hooligan1734-collab/PassPuck/case/PassPuck_case_rp2040.3mf

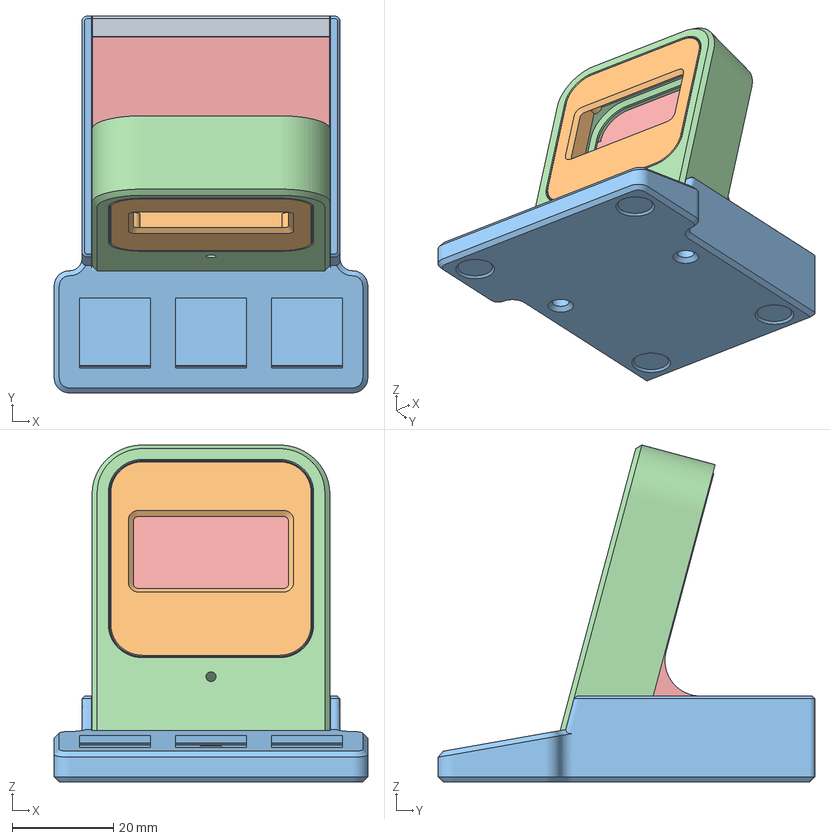
[picture p1: CAD file, 2026-10-15]
case/PassPuck_case_rp2040.3mf
62.0 x 74.5 x 66.6 mm
RP2040-Zero-Holder
бизель 1,3'
корпус кнопок саморезы
корпус экрана вставки
крышка световод
