hooligan1734-collab/PassPuck/docs/PassPuck-manual.pdf

ИНСТРУКЦИЯ ПО СБОРКЕ, ПРОШИВКЕ И РАБОТЕ · PASSPUCK 2.4

# PassPuck

Карманный менеджер паролей. Компьютер видит его как обычную USB-

клавиатуру: выберите профиль кнопками, нажмите «Ввод», и

устройство само наберёт пароль. Ещё PassPuck может не давать

компьютеру уснуть и блокирует его сочетанием кнопок.

6 профилей паролей | пароли на латинице и по-русски | 3 кнопки
экран OLED 1.3″ | плата Waveshare RP2040-Zero | CircuitPython 10.2.1
1. Что понадобится
2. Контакты платы RP2040-Zero
3. Таблица соединений
4. Экран: где какой контакт
5. Кнопки: какие ножки паять
6. Общая схема
7. Пайка и проверка
8. Прошивка
9. Первый запуск
10. Настройка Windows
11. Пароли и названия профилей
12. Управление и меню
13. Пульт для музыки и видео
14. Игра «Змейка»
15. Режим редактирования
16. Тонкая настройка
17. Если что-то не работает
18. Безопасность

## Что понадобится

ДЕТАЛЬ | ЧТО ИМЕННО | КОЛ-ВО
Плата | Waveshare RP2040-Zero (маленькая, с USB-C и RGB-
| светодиодом)

1

Экран | OLED 1.3″ I2C (на обороте надпись «1.30″ IIC», контроллер
| SH1106), 4 контакта. Подойдёт и 0.96″ SSD1306, но тогда
| нужна одна правка в коде (раздел 16)

1

Кнопки | Тактовые кнопки без фиксации, 4 ножки (обычно 6×6 мм) | 3
Провод | Тонкий монтажный (МГТФ 0,07–0,12 мм² или аналог), лучше
| нескольких цветов

~50

см

Корпус | Файл PassGen_full_case_rp2040.3mf из папки 4_корпус
| комплекта

1

Кабель | USB-C с передачей данных (кабели «только для зарядки» не
| подойдут)

1

Инструмент: паяльник (лучше с регулировкой, около 300–330 °C), припой с

флюсом, флюс, кусачки, пинцет, мультиметр. Мультиметр нужен обязательно:

перед первым включением им проверяется, что нет замыкания.

01

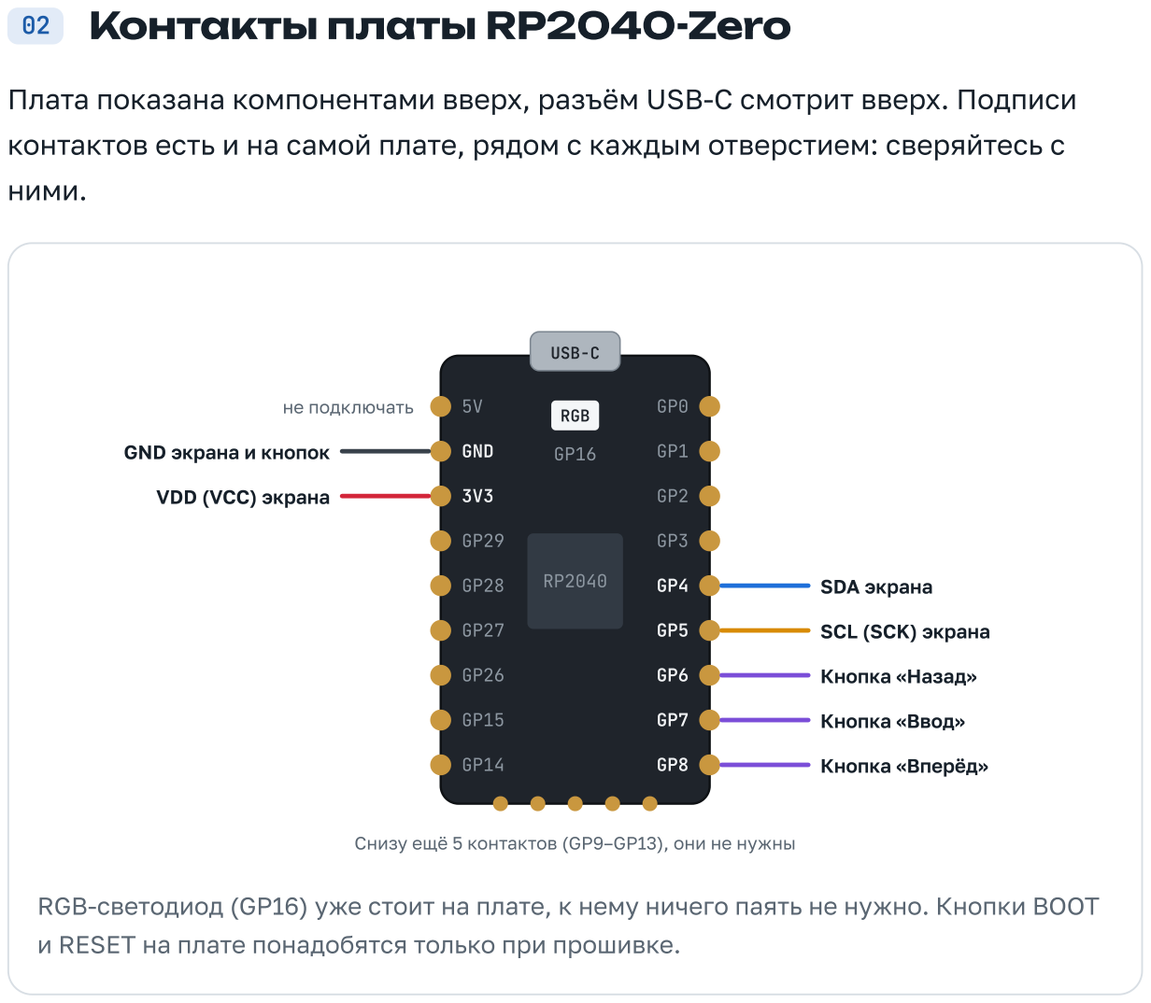
[picture p13: figure]
Контакты платы RP2040⁻Zero; ними.; USB-C; RGB; GND; не подключать; GND экрана и кнопок; VDD (VCC) экрана; SDA экрана; SCL (SCK) экрана; Кнопка «Назад»; Кнопка «Ввод»; Кнопка «Вперёд»

Плата показана компонентами вверх, разъём USB-C смотрит вверх. Подписи

контактов есть и на самой плате, рядом с каждым отверстием: сверяйтесь с

Снизу ещё 5 контактов (GP9–GP13), они не нужны

RGB-светодиод (GP16) уже стоит на плате, к нему ничего паять не нужно. Кнопки BOOT

и RESET на плате понадобятся только при прошивке.

## Таблица соединений

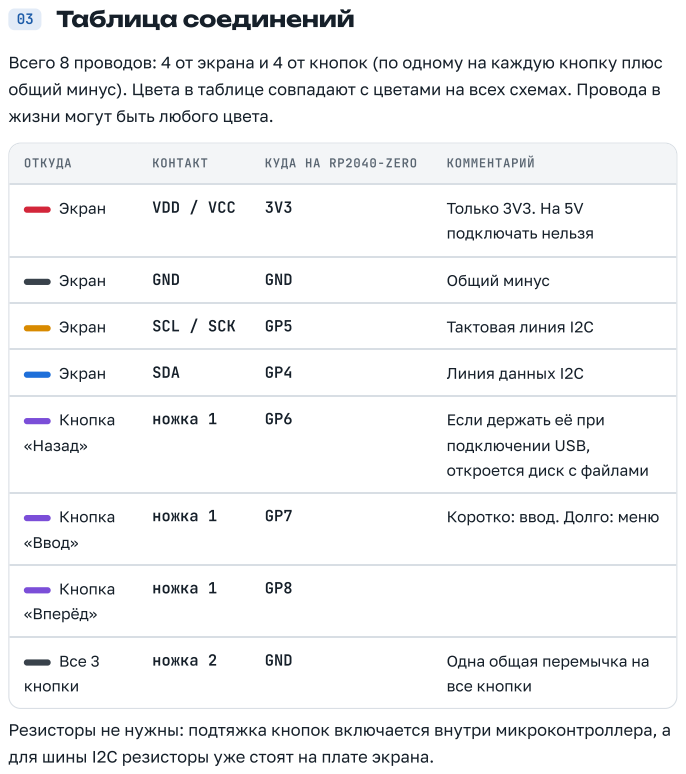
[picture p14: page 4]
ОТКУДА; КОНТАКТ; КУДА НА RP2040-ZERO; КОММЕНТАРИЙ; Экран; VDD / VCC; Только 3V3. На 5V; подключать нельзя; GND; Общий минус; SCL / SCK; Тактовая линия I2C; SDA; Линия данных I2C; Кнопка; «Назад»; ножка 1; Если держать её при; подключении USB,; «Ввод»; Коротко: ввод. Долго: меню; «Вперёд»; Все 3; кнопки; ножка 2; Одна общая перемычка на; все кнопки

Всего 8 проводов: 4 от экрана и 4 от кнопок (по одному на каждую кнопку плюс

общий минус). Цвета в таблице совпадают с цветами на всех схемах. Провода в

жизни могут быть любого цвета.

откроется диск с файлами

Резисторы не нужны: подтяжка кнопок включается внутри микроконтроллера, а

для шины I2C резисторы уже стоят на плате экрана.

## Экран: где какой контакт

У экрана 4 контакта в один ряд. Подписи обычно напечатаны на лицевой

стороне, над стеклом. С обратной стороны подписей нет, и порядок там

зеркальный: пин 1, который спереди крайний слева, сзади оказывается крайним

справа.

VDD | GND | SCL | SDA
1 | 2 | 3 | 4

стекло

3V3 | GND | GP5 | GP4

Спереди: стекло смотрит на вас

SDA | SCL | GND | VDD
4 | 3 | 2 | 1

1.30" IIC

перемычки 1(VDD) · 1(GND)

шлейф стекла

GP4 | GP5 | GND | 3V3

Сзади: так экран лежит в корпусе

Над каждым контактом подписано, куда он идёт на RP2040-Zero. Показан самый

распространённый вариант: пин 1 = VDD, пин 2 = GND.

Перед пайкой проверьте, где у вашего экрана плюс, а где минус

На экранах 1.3″ первые два контакта можно поменять местами перемычками на

обороте. Бывают модули с порядком GND VDD SCL SDA . Если перепутать питание,

экран сгорит. SDA и SCL всегда стоят на 3-м и 4-м местах, их путаница ничего не

сожжёт.

Как узнать порядок, если подписи спереди не видно

На обороте у разъёма есть две строки перемычек: 1(VDD) … 1(GND) и

2(VDD) … 2(GND) . В каждой строке стоит маленький чёрный резистор-

перемычка, и он сдвинут к одной из надписей. Эта надпись и есть назначение

контакта.

04

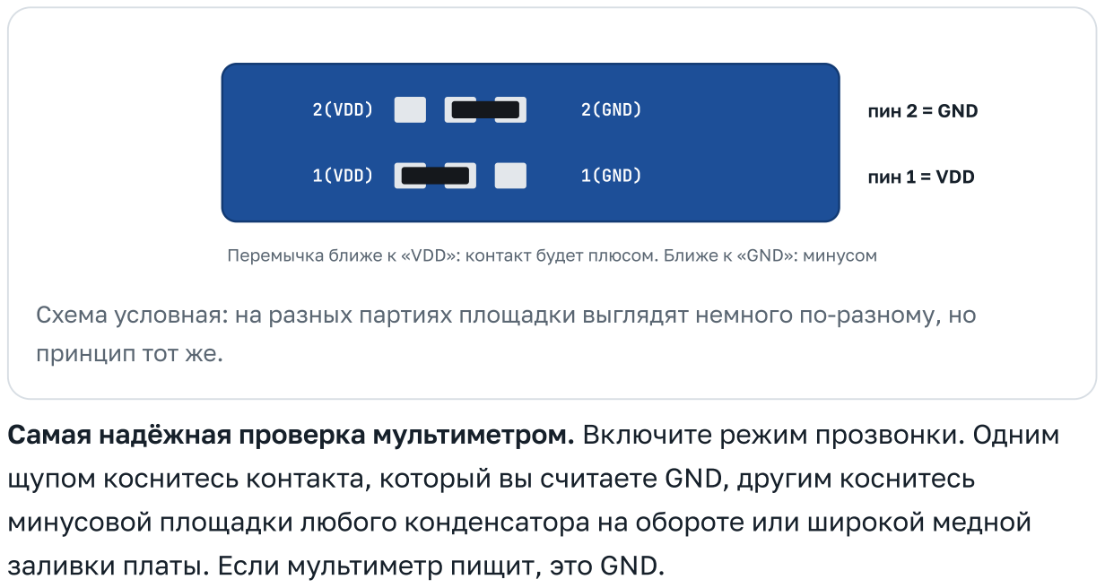
[picture p15: figure]
2(VDD); 2(GND); 1(VDD); 1(GND); пин 2 = GND; пин 1 = VDD; принцип тот же.

Перемычка ближе к «VDD»: контакт будет плюсом. Ближе к «GND»: минусом

Схема условная: на разных партиях площадки выглядят немного по-разному, но

Самая надёжная проверка мультиметром. Включите режим прозвонки. Одним

щупом коснитесь контакта, который вы считаете GND, другим коснитесь

минусовой площадки любого конденсатора на обороте или широкой медной

заливки платы. Если мультиметр пищит, это GND.

## Кнопки: какие ножки паять

У тактовой кнопки 4 ножки, но внутри они попарно соединены. Если припаять

оба провода к ножкам одной пары, кнопка будет «нажата» всегда. Самый

простой способ не ошибиться: паять на ножки по диагонали. Они всегда

относятся к разным парам.

Правильно: по диагонали

к GP

к GND

Работает при любом повороте кнопки

Неправильно: одна пара

к GP | к GND

Ножки уже соединены внутри:

кнопка «нажата» постоянно

Пунктир показывает, какие ножки соединены внутри кнопки всегда

Проверка мультиметром: между выбранными ножками в покое тишина, при нажатии

кнопки писк.

Вторые ножки всех трёх кнопок соедините одной общей перемычкой (голый

луженый провод или отрезок МГТФ от кнопки к кнопке) и одним проводом

заведите на GND платы.

05

## Общая схема

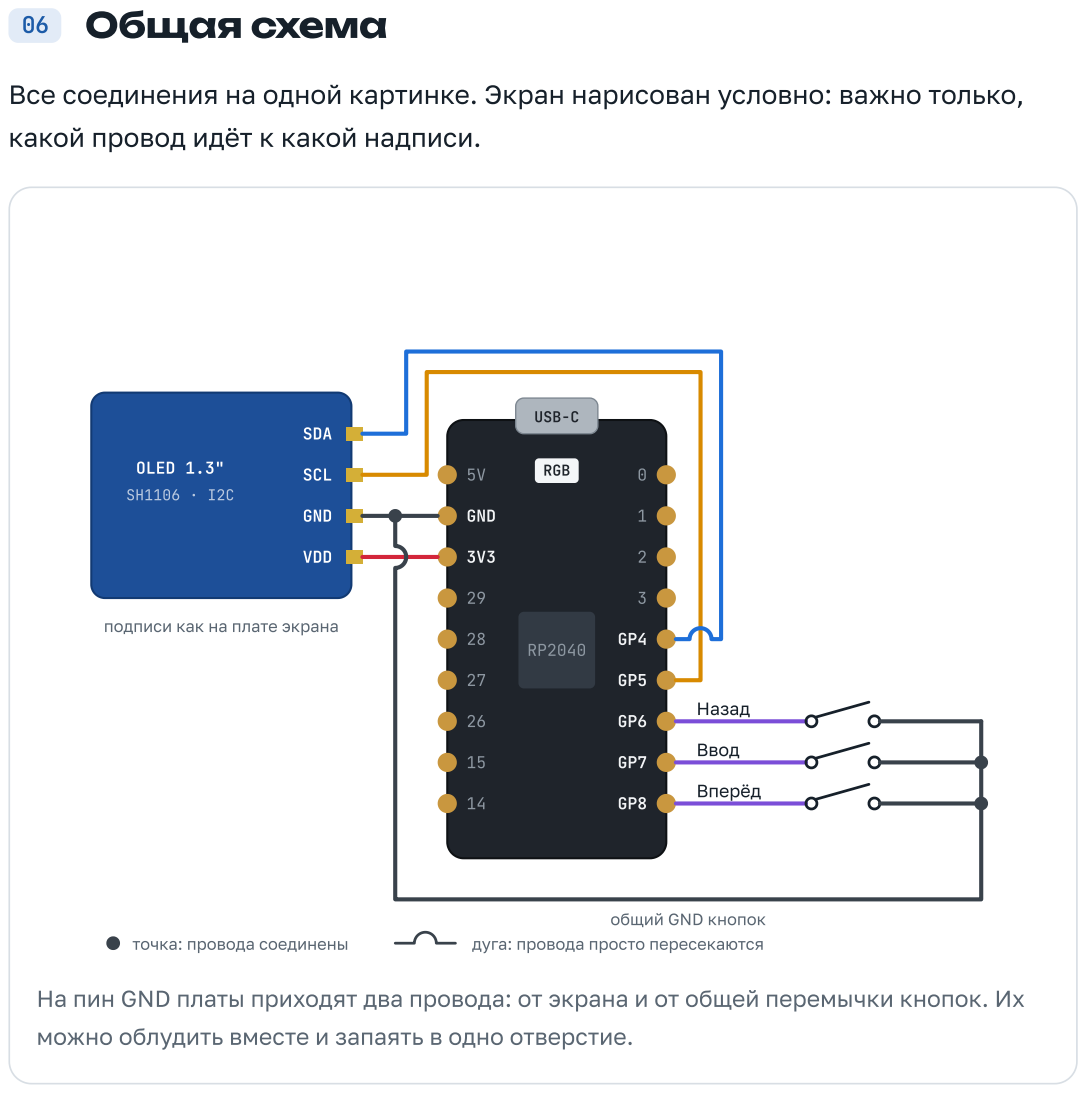
[picture p16: page 8]
OLED 1.3"; SDA; SCL; GND; VDD; USB-C; RGB; Назад; Ввод; Вперёд; точка: провода соединены; дуга: провода просто пересекаются

Все соединения на одной картинке. Экран нарисован условно: важно только,

какой провод идёт к какой надписи.

подписи как на плате экрана

общий GND кнопок

На пин GND платы приходят два провода: от экрана и от общей перемычки кнопок. Их

можно облудить вместе и запаять в одно отверстие.

## Пайка и проверка

Проверка мультиметром до первого подключения к USB

В режиме прозвонки проверьте:

07

Примерьте детали в корпусе. Прикиньте длину проводов с запасом 1–2 см,

чтобы крышка закрывалась без натяга.

1

Залудите все точки пайки: отверстия платы GND, 3V3, GP4–GP8, штырьки

экрана и ножки кнопок. Концы проводов зачистите на 2–3 мм и тоже

залудите.

2

Экран. Определите VDD и GND (раздел 4), затем припаяйте 4 провода

прямо к штырькам. Лишнюю длину штырьков можно откусить, если они

мешают крышке.

3

Кнопки. Сначала соедините вторые ножки всех трёх кнопок общей

перемычкой, потом припаяйте к первым ножкам провода на GP6, GP7, GP8

(раздел 5).

4

Плата. Припаяйте всё к RP2040-Zero по таблице. Паяйте быстро и не

перегревайте плату: 2–3 секунды на точку.

5

Осмотрите пайку. Не должно быть капель припоя между соседними

контактами, особенно между GND и 3V3: они стоят рядом.

6

3V3 и GND платы не звонятся между собой. Если пищит, где-то замыкание,

искать его нужно до включения;

GP4 и GP5 не звонятся с GND и друг с другом;

GP6, GP7, GP8 звонятся с GND только при нажатии своей кнопки.

## Прошивка

Прошивка делается один раз на каждое устройство, и это один файл:

PassPuck-2.4.uf2 из комплекта PassPuck kit.zip (или со страницы Releases на

GitHub). В нём сразу и CircuitPython, и все файлы PassPuck.

шаг 1

Зажать BOOT

Держите кнопку

BOOT на плате и

вставьте USB.

Затем отпустите.

Совсем новая

плата может

открыться и без

кнопки.

шаг 2

Диск RPI-RP2

В «Этом

компьютере»

появится новый

диск, это

загрузчик платы.

шаг 3

Перетащить

.uf2

Перетащите на

него

PassPuck-2.4.uf2

и подождите

около 30 секунд.

шаг 4

Диск CIRCUITPY

Плата

перезагрузится

сама. На экране

«PassPuck

setup», на

компьютере диск

с редактором

паролей.

Дальше — раздел 9.

Только для нового устройства

PassPuck-2.4.uf2 записывает всё заново, и пароли тоже — они станут пустыми.

Работающее устройство обновляйте копированием файлов (ниже).

Что лежит на диске CIRCUITPY

Это для справки и для ручной установки: можно прошить только CircuitPython

( 1_прошивка в комплекте) и скопировать всё из 2_на_устройство в корень

диска. Порядок важен: boot.py всегда последним.

08

CIRCUITPY/

├── lib/ | # библиотеки, папка целиком
├── fonts/ | # шрифт с русскими буквами
├── code.py | # запуск программы (не менять)
├── passpuck.mpy | # сама программа, собранная заранее
├── settings.py | # настройки, можно менять Блокнотом
├── passwords.py | # пароли и названия профилей
├── words.txt | # словарь для паролей из слов
├── PassPuck Editor.html | # редактор паролей

└── boot.py последним

Появятся сами: log.txt | passwords.bak | boot_out.txt
Не нужны: .fseventsd | .Trashes | .Trash-1000 | sd/
.metadata_never_index | settings.toml служебный мусор

Почему boot.py последним

boot.py прячет диск CIRCUITPY при каждом включении. Если скопировать его

раньше остальных файлов и плата перезагрузится, диск пропадёт. Тогда откройте

его кнопкой «Назад» (раздел 15) и докопируйте файлы.

Обновление уже работающего устройства

Откройте диск (раздел 15) и скопируйте всё из 2_на_устройство , кроме

passwords.py и settings.py : в них ваши пароли и настройки. Если на

устройстве лежит hardware_pins.py , не удаляйте его. boot.py — последним.

Версия CircuitPython

Программа passpuck.mpy собрана для CircuitPython 10 — прошивка из комплекта

как раз такая. На CircuitPython 11 и новее она не запустится: светодиод будет

мигать красным «два коротких — пауза». Тогда прошейте плату файлом из

комплекта.

## Первый запуск

Пока в устройстве нет ни одного пароля, оно работает в режиме первой

настройки:

Откройте на диске PassPuck Editor.html , впишите или создайте пароли и

сохраните (раздел 11). Подождите 10 секунд и переподключите устройство.

Теперь оно в обычном режиме:

Хочу создавать пароли прямо на устройстве

Вместо редактора выберите на устройстве SETTINGS → Exit edit mode. Оно

запомнит это, перезапустится в обычном режиме, и пароли профилей 1–3 можно

будет создать через Gen Pass (раздел 12).

09

на секунду появляется заставка PassPuck и номер версии;

затем подсказка

PassPuck setup — Open disk CIRCUITPY — PassPuck Editor.html ;

на компьютере сам появляется диск CIRCUITPY;

внизу главного экрана надпись Open Editor.html .

главный экран: номер профиля 1/6 , крупное название, внизу точки «где я»;

светодиод медленно пульсирует синим;

диск CIRCUITPY не появляется: так задумано, это защита.

## Настройка Windows

Устройство набирает пароль, нажимая клавиши, а какая буква получится,

решает раскладка Windows. Поэтому перед каждым паролем устройство само

переключает раскладку сочетаниями клавиш. Эти сочетания нужно один раз

настроить на каждом компьютере, где используется PassPuck.

Одним щелчком

Дважды щёлкните Настроить Windows.cmd из комплекта (папка 3_windows ) и

отвечайте на вопросы. Скрипт:

проверит, что в Windows есть английский и русский языки (русский

предложит добавить);

назначит Ctrl + Shift + 1 английскому и Ctrl + Shift + 2 русскому;

по желанию скопирует настройки на экран входа в Windows — Windows

спросит разрешение администратора.

Если сочетания не заработали сразу, выйдите из Windows и войдите снова.

Вручную

Чтобы пароль набирался на экране входа в Windows

Экран блокировки работает со своими настройками языка и про сочетания из

шагов выше не знает. Для пароля от Windows скопируйте их туда (нужны права

администратора):

10

Windows 11: Параметры → Время и язык → Ввод → Дополнительные

параметры клавиатуры → Сочетания клавиш для языков ввода.

1

Выберите строку с английским языком → «Сменить сочетание клавиш» →

Ctrl + Shift + 1 .

2

3 | Выберите строку с русским языком → Ctrl + Shift + 2 .
1 | Win + R → intl.cpl → Enter.
2 | Вкладка «Дополнительно» → «Копировать параметры…».

Для профиля с паролем от Windows включите в его меню Ctrl first (раздел 12),

иначе первый символ может потеряться на заставке с часами.

Mac, Linux или чужой компьютер без настройки

Выберите на устройстве SETTINGS → Layout: Off. Тогда PassPuck не трогает

раскладку, и нужный язык вы включаете сами перед нажатием «Ввод». Пароль с

русскими и латинскими буквами вперемешку в этом режиме набрать не

получится.

Отметьте «Экран приветствия и системные учётные записи» → ОК,

перезагрузите компьютер.

3

## Пароли и названия профилей

Профили 1–3 «автоматические»: пароль для них можно сгенерировать прямо на

устройстве. Профили 4–6 «фиксированные»: пароль задаётся только в файле.

Названия профилей на экране можно писать по-русски.

Способ 1. Редактор (удобнее и надёжнее)

Редактор лежит прямо на устройстве, ничего устанавливать не нужно. Работает

в Microsoft Edge или Google Chrome, без интернета.

Редактор сам подсвечивает символы, которые устройство не сможет набрать, и

не даёт сохранить такой файл. Перед сохранением прежняя версия файла

копируется в passwords.bak .

Пароли из слов

Случайный пароль вроде k#8Fq2!xZ… надёжен, но запомнить его почти

невозможно. Пароль из слов устройство тоже выбирает случайно, но из простых

слов в 3–4 буквы: два слова, две цифры и символ.

11

1 | Откройте диск устройства: SETTINGS → Edit mode → «Ввод» (раздел 15).
2 | На диске CIRCUITPY дважды кликните PassPuck Editor.html .
| Нажмите «Открыть устройство», выберите сам диск CIRCUITPY и
| разрешите браузеру изменять файлы.

3

Поменяйте названия и пароли. Кнопка «Создать» генерирует пароль: EN

(буквы, цифры, символы) или RU (русские буквы и цифры) нужной длины,

«Слова» или «Слова RU» — запоминаемый пароль из двух слов (ниже).

Глазик показывает пароль, а у пароля из слов — ещё и подсказку, как его

запомнить.

4

«Сохранить на устройство» → дождитесь зелёного «Сохранено и

проверено» → подождите 10 секунд → на устройстве SETTINGS → Exit edit

mode.

5

ВИД | ВЫ ПОМНИТЕ | ВВОДИТСЯ | ЗАЧЕМ
Words | Кот Луна

47!

RjnKeyf47! | Русские слова, набранные в английской

раскладке. Только латиница — подходит

любому сайту. Вручную печатаете

«котлуна», не переключая раскладку

Words

RU

Кот Луна

47!

КотЛуна47! | Те же слова русскими буквами. Символ в
| конце ( ! % * + - = ) стоит на той же
| клавише в обеих раскладках, поэтому
| весь пароль набирается на русской

Слова берутся из файла words.txt на устройстве (467 слов). Его можно открыть

Блокнотом: удалить слова, которые не нравятся, или добавить свои — по одному

на строке, 3–4 буквы, без букв ж х ъ э б ю ё. «Show Pass» у пароля Words

показывает под ним русскую подсказку.

Насколько это надёжно

Вариантов такого пароля — около 130–175 миллионов. Для входа в Windows этого

с запасом: после 10 неверных попыток Windows блокирует вход. Для почты,

банка и важных сайтов лучше обычный случайный пароль EN.

Способ 2. Вручную в Блокноте

PROFILE_NAMES = {

1: "Рабочая почта",

2: "Ноутбук",

}

AUTO_PASSWORDS = {

1: "пароль профиля 1",

2: "пароль профиля 2",

3: "пароль профиля 3",
}

MANUAL_PASSWORDS = {

4: "пароль профиля 4",

5: "пароль профиля 5",

6: "пароль профиля 6",
}

Меняйте только текст внутри кавычек. Кавычки, двоеточия и запятые не

трогайте.

Можно: латиница, цифры, символы английской клавиатуры, русские буквы

(включая ё и №). Перед " и \ ставьте обратный слэш: \" и \\ .

Названия профилей: до 20 символов, иначе обрежутся на экране.

После сохранения подождите 10 секунд, прежде чем отключать устройство.

Если выдернуть его сразу, файл может испортиться.

Если файл всё-таки испортился

При включении устройство попробует резервную копию passwords.bak и

покажет на экране Backup loaded . Если не читается ни один файл, будет

passwords.py ERROR . Тогда откройте диск и запишите пароли заново

редактором.

## Управление и меню

Главный экран листается по кругу: профили 1–6 → (MEDIA) → (GAME) → JIGGLE →

SETTINGS → профиль 1. Экраны MEDIA и GAME появляются, только если

включить их в SETTINGS (пульт, игра). После включения устройство открывает

профиль, которым вы пользовались последним.

Главный экран профиля

слева вверху — номер профиля, например 2/6 ;

справа вверху — значки: ENT (после пароля нажимается Enter), CTL (Ctrl

first) — видны, только когда включены, и вид генерации EN / RU / Words /

Words RU (профили 1–3);

в центре — название профиля, крупно, если оно не длиннее 10 символов;

внизу — точки «где я»: кружки — профили, квадраты — MEDIA и GAME (если

включены), JIGGLE и SETTINGS. Если у профиля нет пароля, вместо точек

написано No password! .

ДЕЙСТВИЕ | НА ГЛАВНОМ ЭКРАНЕ | В МЕНЮ

«Вперёд» /

«Назад»

Следующий / предыдущий экран | Следующий /
| предыдущий пункт

«Вперёд» /

«Назад» держать

Листать само, пока кнопку не отпустите (примерно 4 шага в

секунду)

«Ввод» коротко | Набрать пароль профиля. На JIGGLE —
| вкл/выкл. На SETTINGS — открыть
| меню

Выбрать пункт

«Ввод» держать

1 с

Открыть меню профиля, JIGGLE или

SETTINGS

Выйти из меню

«Назад» +

«Вперёд»

держать 1 с

Заблокировать компьютер ( Win + L )

«Вперёд» и «Назад» срабатывают в момент отпускания кнопки. Поэтому при

блокировке Win+L профиль на экране не сдвигается — нажимайте обе кнопки

12

почти одновременно.

Меню показывает 4 пункта списком: выбранный выделен белой полосой,

значения настроек — справа, вверху — номер пункта, сбоку — полоска

прокрутки. Каждое меню открывается на том пункте, где вы его закрыли. Выйти

можно пунктом Exit или долгим «Вводом» с любого пункта.

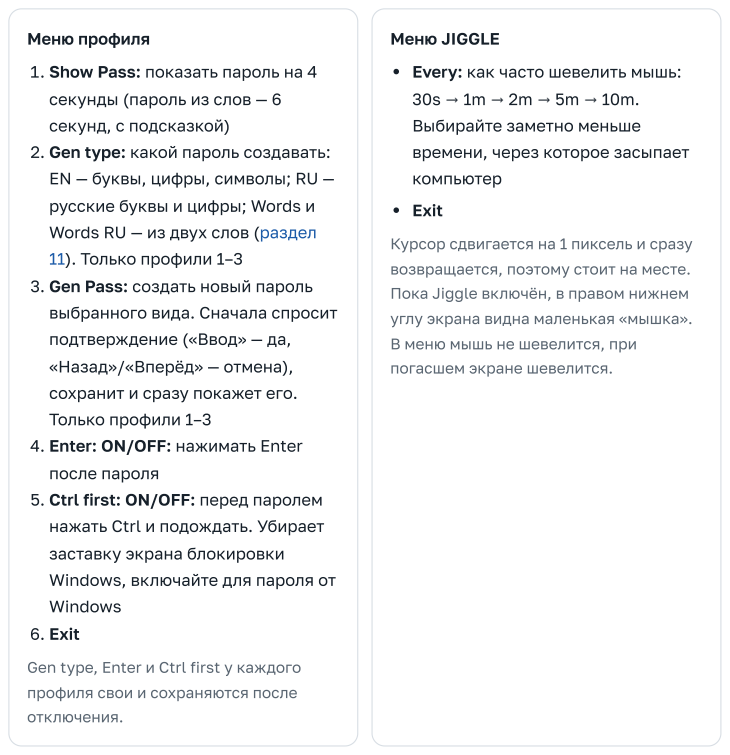
[picture p17: page 20]
Меню профиля; секунд, с подсказкой); 11). Только профили 1–3; Только профили 1–3; после пароля; Windows; 6. Exit; отключения.; Меню JIGGLE; компьютер; Exit

1. Show Pass: показать пароль на 4

Every: как часто шевелить мышь:

секунды (пароль из слов — 6

Выбирайте заметно меньше

2. Gen type: какой пароль создавать:

времени, через которое засыпает

EN — буквы, цифры, символы; RU —

русские буквы и цифры; Words и

Words RU — из двух слов (раздел

Курсор сдвигается на 1 пиксель и сразу

возвращается, поэтому стоит на месте.

3. Gen Pass: создать новый пароль

Пока Jiggle включён, в правом нижнем

выбранного вида. Сначала спросит

углу экрана видна маленькая «мышка».

подтверждение («Ввод» — да,

В меню мышь не шевелится, при

«Назад»/«Вперёд» — отмена),

погасшем экране шевелится.

сохранит и сразу покажет его.

4. Enter: ON/OFF: нажимать Enter

5. Ctrl first: ON/OFF: перед паролем

нажать Ctrl и подождать. Убирает

заставку экрана блокировки

Windows, включайте для пароля от

Gen type, Enter и Ctrl first у каждого

профиля свои и сохраняются после

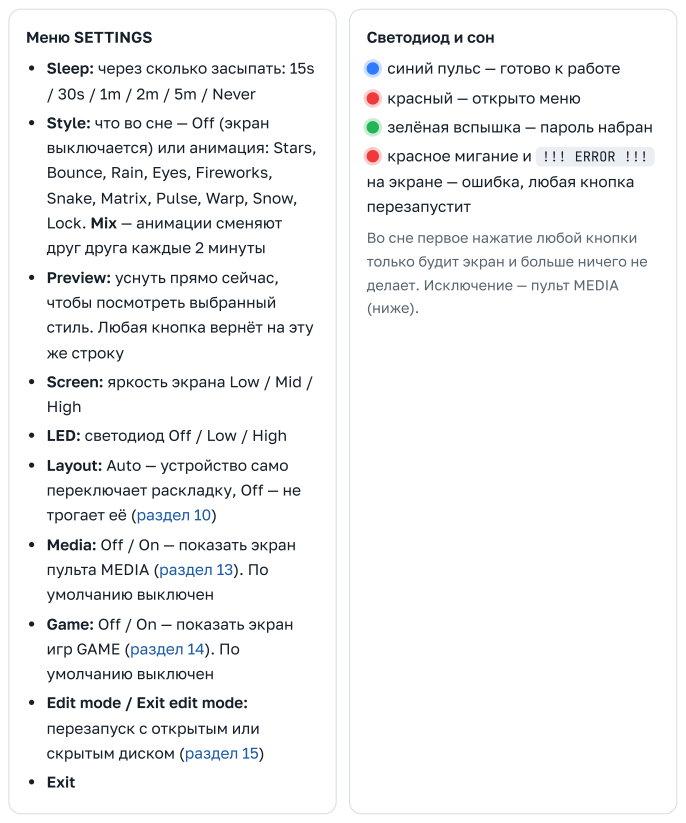
[picture p18: page 21]
Меню SETTINGS; / 30s / 1m / 2m / 5m / Never; же строку; High; умолчанию выключен; Exit; Светодиод и сон; перезапустит; (ниже).

Sleep: через сколько засыпать: 15s

синий пульс — готово к работе

красный — открыто меню

Style: что во сне — Off (экран

зелёная вспышка — пароль набран

выключается) или анимация: Stars,

красное мигание и !!! ERROR !!!

Bounce, Rain, Eyes, Fireworks,

на экране — ошибка, любая кнопка

Snake, Matrix, Pulse, Warp, Snow,

Lock. Mix — анимации сменяют

Во сне первое нажатие любой кнопки

друг друга каждые 2 минуты

только будит экран и больше ничего не

Preview: уснуть прямо сейчас,

делает. Исключение — пульт MEDIA

чтобы посмотреть выбранный

стиль. Любая кнопка вернёт на эту

Screen: яркость экрана Low / Mid /

LED: светодиод Off / Low / High

Layout: Auto — устройство само

переключает раскладку, Off — не

трогает её (раздел 10)

Media: Off / On — показать экран

пульта MEDIA (раздел 13). По

Game: Off / On — показать экран

игр GAME (раздел 14). По

Edit mode / Exit edit mode:

перезапуск с открытым или

скрытым диском (раздел 15)

## Пульт для музыки и видео

PassPuck умеет управлять музыкой и видео на компьютере: пауза, треки,

громкость. Работает в любом плеере, YouTube, Spotify — программы на

компьютере не нужны. Пульт нужен не всем, поэтому по умолчанию он

выключен.

КНОПКА В РЕЖИМЕ ПУЛЬТА | ЧТО ДЕЛАЕТ
«Ввод» | Пауза / воспроизведение
«Вперёд» / «Назад» | Следующий / предыдущий трек
«Вперёд» / «Назад» держать | Громче / тише, пока держите
«Ввод» держать 1 с | Выйти из режима пульта
«Назад» + «Вперёд» держать 1 с | Заблокировать компьютер, как везде

Внизу экрана на секунду видно, что нажато: Next > , Volume + и т.п.

Сон пульту не мешает

Экран гаснет как обычно, но устройство остаётся в режиме пульта. Нажатие на

погасшем экране сразу выполняет действие — например, ставит паузу, без

лишнего «разбудить». С паролями так не бывает: там первое нажатие только

будит экран.

После переподключения устройство открывается на последнем профиле, а пульт

включается заново одним нажатием на экране MEDIA. Убрать пульт совсем:

SETTINGS → Media: Off.

13

Включите: SETTINGS → Media: On. В карусели после профиля 6 появится

экран MEDIA, внизу — ещё одна точка.

1

Долистайте до MEDIA и нажмите «Ввод» — включится режим пульта, на

экране значки ⏮ ⏯ ⏭.

2

## Игра «Змейка»

Чтобы скоротать минутку, на PassPuck есть змейка. Как и пульт, она по

умолчанию выключена.

КНОПКА В ИГРЕ | ЧТО ДЕЛАЕТ
«Назад» | Повернуть налево — относительно того, куда
| ползёт змейка
«Вперёд» | Повернуть направо
«Ввод» | Пауза / продолжить
«Ввод» держать 1 с | Выйти из игры

«Назад» + «Вперёд»

держать 1 с

Заблокировать компьютер (игра встанет на паузу)

Walls: Solid — поле обведено сплошной рамкой, врезаться в неё нельзя. Walls:

Wrap — рамка пунктиром: вышли за край — появились с другой стороны.

Каждая съеденная точка — +1 к счёту, змейка растёт и чуть ускоряется. Счёт и

рекорд — вверху экрана.

После проигрыша: «Ввод» — сыграть ещё, держать «Ввод» — выйти. Рекорд

сохраняется и после отключения.

Пока идёт игра, экран не засыпает, пароли не вводятся, Jiggle продолжает

работать.

14

Включите: SETTINGS → Game: On. В карусели появится экран GAME (между

MEDIA и JIGGLE).

1

2 На экране GAME нажмите «Ввод» → Snake (справа — ваш рекорд).

Выберите Speed (Easy / Normal / Hard) и Walls, затем Start. Выбор

запоминается.

3

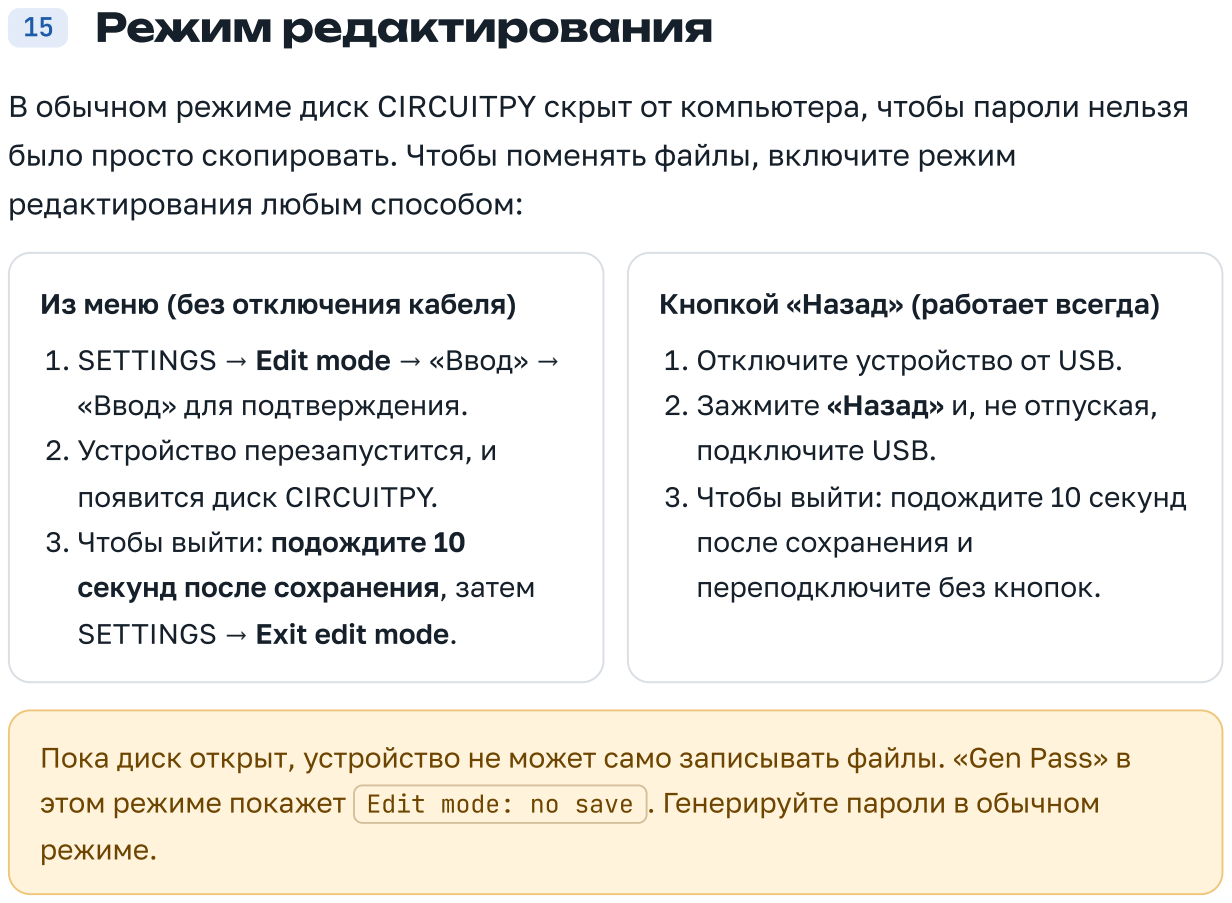
[picture p19: figure]
Режим редактирования; редактирования любым способом:; Из меню (без отключения кабеля); 1. SETTINGS → Edit mode → «Ввод» →; «Ввод» для подтверждения.; 2. Устройство перезапустится, и; появится диск CIRCUITPY.; 3. Чтобы выйти: подождите 10; секунд после сохранения, затем; SETTINGS → Exit edit mode.; Кнопкой «Назад» (работает всегда); 1. Отключите устройство от USB.; 2. Зажмите «Назад» и, не отпуская,; подключите USB.; 3. Чтобы выйти: подождите 10 секунд; после сохранения и; переподключите без кнопок.; режиме.

В обычном режиме диск CIRCUITPY скрыт от компьютера, чтобы пароли нельзя

было просто скопировать. Чтобы поменять файлы, включите режим

Пока диск открыт, устройство не может само записывать файлы. «Gen Pass» в

этом режиме покажет Edit mode: no save . Генерируйте пароли в обычном

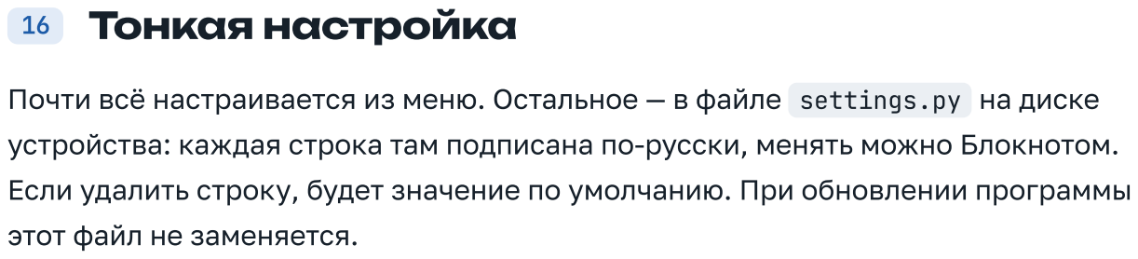
[picture p20: figure]
Тонкая настройка; этот файл не заменяется.

Почти всё настраивается из меню. Остальное — в файле settings.py на диске

устройства: каждая строка там подписана по-русски, менять можно Блокнотом.

Если удалить строку, будет значение по умолчанию. При обновлении программы

НАСТРОЙКА | ЧТО МЕНЯЕТ
OLED_TYPE | "SH1106" для экрана 1.3″, "SSD1306" для

0.96″

PASSWORD_LENGTH , CHARS | Длина и символы пароля EN для Gen Pass

WORDS_SYMBOLS ,

WORDS_RU_SYMBOLS

Из каких символов выбирается последний

символ пароля Words и Words RU (сами

слова — в words.txt )

NAV_REPEAT_DELAY ,

NAV_REPEAT_INTERVAL

Через сколько секунд удержания

«Вперёд»/«Назад» листают сами и с какой

скоростью

MEDIA_VOLUME_INTERVAL | Пульт MEDIA: как быстро меняется
| громкость, пока держите «Вперёд»/«Назад»

TYPING_DELAY ,

TYPING_START_DELAY

Пауза между символами и пауза после Ctrl

first

LANG_EN_HOTKEY ,

LANG_RU_HOTKEY ,

LANG_SWITCH_DELAY

Сочетания переключения раскладки и пауза

после него

SLEEP_PRESETS , JIGGLE_PRESETS | Варианты времени сна и интервалов Jiggle в
| меню

MIX_PERIOD ,

ANIMATION_FRAME_TIME

Сколько секунд показывать каждую

анимацию в Mix и скорость анимаций

SPLASH_TIME | Сколько секунд показывать заставку, 0 — не
| показывать
I2C_FREQUENCY | Скорость связи с экраном. Если на экране
помехи — | 100000

Если кнопки припаяны не к тем контактам

Перепаивать не обязательно. Положите на устройство рядом с settings.py

файл hardware_pins.py только с теми кнопками, которые нужно поменять.

Например, если перепутаны «Ввод» и «Вперёд»:

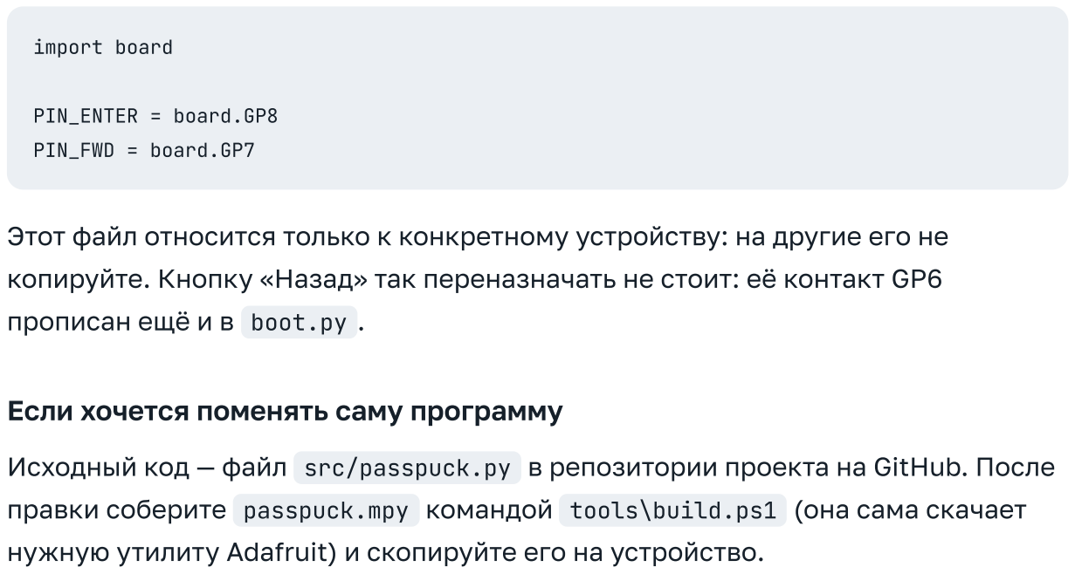
[picture p21: figure]
import board; PIN_ENTER = board.GP8; PIN_FWD = board.GP7; прописан ещё и в boot.py .; Если хочется поменять саму программу

Этот файл относится только к конкретному устройству: на другие его не

копируйте. Кнопку «Назад» так переназначать не стоит: её контакт GP6

Исходный код — файл src/passpuck.py в репозитории проекта на GitHub. После

правки соберите passpuck.mpy командой tools\build.ps1 (она сама скачает

нужную утилиту Adafruit) и скопируйте его на устройство.

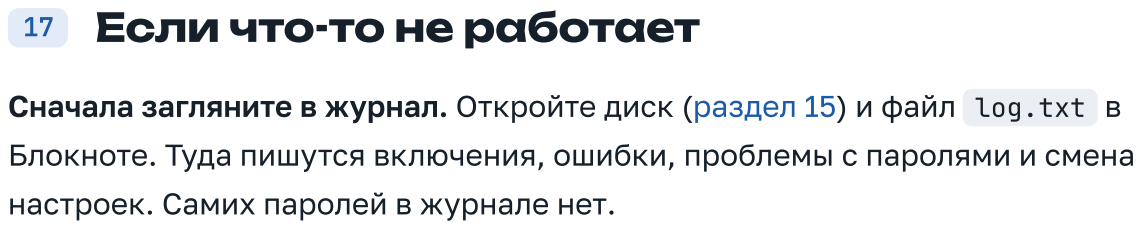
[picture p22: figure]
Если что⁻то не работает; настроек. Самих паролей в журнале нет.

Сначала загляните в журнал. Откройте диск (раздел 15) и файл log.txt в

Блокноте. Туда пишутся включения, ошибки, проблемы с паролями и смена

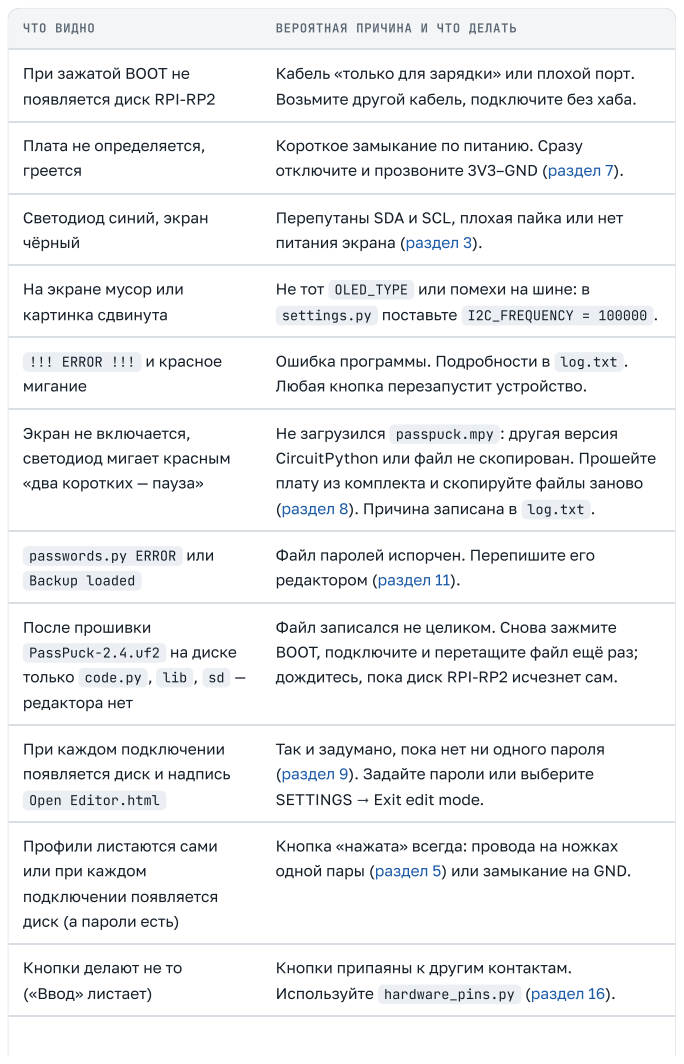
[picture p23: page 29]
ЧТО ВИДНО; ВЕРОЯТНАЯ ПРИЧИНА И ЧТО ДЕЛАТЬ; греется; чёрный; картинка сдвинута; !!! ERROR !!! и красное; мигание; Backup loaded; редактором (раздел 11).; После прошивки; редактора нет; подключении появляется; («Ввод» листает)

При зажатой BOOT не

Кабель «только для зарядки» или плохой порт.

появляется диск RPI-RP2

Возьмите другой кабель, подключите без хаба.

Плата не определяется,

Короткое замыкание по питанию. Сразу

отключите и прозвоните 3V3–GND (раздел 7).

Светодиод синий, экран

Перепутаны SDA и SCL, плохая пайка или нет

питания экрана (раздел 3).

На экране мусор или

Не тот OLED_TYPE или помехи на шине: в

settings.py поставьте I2C_FREQUENCY = 100000 .

Ошибка программы. Подробности в log.txt .

Любая кнопка перезапустит устройство.

Экран не включается,

Не загрузился passpuck.mpy : другая версия

светодиод мигает красным

CircuitPython или файл не скопирован. Прошейте

«два коротких — пауза»

плату из комплекта и скопируйте файлы заново

(раздел 8). Причина записана в log.txt .

passwords.py ERROR или

Файл паролей испорчен. Перепишите его

Файл записался не целиком. Снова зажмите

PassPuck-2.4.uf2 на диске

BOOT, подключите и перетащите файл ещё раз;

только code.py , lib , sd —

дождитесь, пока диск RPI-RP2 исчезнет сам.

При каждом подключении

Так и задумано, пока нет ни одного пароля

появляется диск и надпись

(раздел 9). Задайте пароли или выберите
SETTINGS → Exit edit mode.

Open Editor.html

Профили листаются сами

Кнопка «нажата» всегда: провода на ножках

или при каждом

одной пары (раздел 5) или замыкание на GND.

диск (а пароли есть)

Кнопки делают не то

Кнопки припаяны к другим контактам.

Используйте hardware_pins.py (раздел 16).

ЧТО ВИДНО | ВЕРОЯТНАЯ ПРИЧИНА И ЧТО ДЕЛАТЬ
Печатаются не те символы | Не настроены Ctrl + Shift + 1/2 в Windows
| (раздел 10), либо это Mac/Linux — выберите
| Layout: Off.
Bad chars in P… | В пароле символ, который нельзя набрать (не
| латиница и не русская буква). Исправьте в
| редакторе.

На экране блокировки не

хватает первого символа

Включите в меню профиля Ctrl first.

Русский пароль не проходит

на экране входа

Скопируйте языковые настройки на экран

приветствия: Настроить Windows.cmd или

intl.cpl (раздел 10).

Gen Pass в режиме Words

пишет No words.txt

На устройстве нет словаря или в нём меньше 100

слов. Скопируйте words.txt из комплекта.

Gen Pass пишет

Edit mode: no save

Устройство в режиме редактирования. Выйдите

из него и повторите.

Нет экрана MEDIA | Пульт выключен по умолчанию: SETTINGS →
| Media: On (раздел 13).
Нет экрана GAME | Игры выключены по умолчанию: SETTINGS →
| Game: On (раздел 14).

Пульт MEDIA не управляет

плеером

Проверьте громкость: если она меняется, пульт

работает, а плеер не понимает мультимедийные

клавиши. Браузер (YouTube), Spotify, VLC и

встроенные плееры Windows их понимают.

Компьютер всё равно

засыпает при включённом

Jiggle

Интервал Every больше или равен времени сна

компьютера. Выберите меньше.

Если программа на устройстве испортилась целиком, прошейте его заново

файлом PassPuck-2.4.uf2 (раздел 8). Пароли при этом станут пустыми — если

диск ещё открывается, сначала скопируйте себе passwords.py .

## Безопасность

Пароли хранятся во флеш-памяти открытым текстом: в passwords.py и в

предыдущей версии passwords.bak . Любой, кто знает про режим

редактирования, может их прочитать. Обращайтесь с устройством как с

ключами от квартиры.

«Show Pass» показывает пароль на экране. Не открывайте его при

посторонних.

Устройство набирает пароль туда, где стоит курсор. Перед «Вводом»

убедитесь, что курсор в поле пароля, а не в чате.

Журнал log.txt паролей не содержит. Редактор работает без интернета и

никуда ничего не отправляет.

Быстро заблокировать компьютер: «Назад» + «Вперёд» на 1 секунду.

PassPuck 2.4 · Waveshare RP2040-Zero · CircuitPython 10.2.1 · OLED SH1106 1.3″ I2C, адрес 0x3C ·

шрифт Terminus (SIL OFL 1.1)

18
