hooligan1734-collab/PassPuck/device/settings.py

# =====================================================================
#  PassPuck — НАСТРОЙКИ
#  Меняйте значения справа от «=». Если удалить строку, будет значение
#  по умолчанию. После сохранения подождите 10 секунд, прежде чем отключать
#  устройство. При обновлении программы этот файл не заменяется.
#
#  Пароли и названия профилей — не здесь, а в passwords.py
#  (удобнее через PassPuck Editor.html).
# =====================================================================

import board
from adafruit_hid.keycode import Keycode

# Тип экрана: "SH1106" — экран 1.3", "SSD1306" — экран 0.96"
OLED_TYPE = "SH1106"

# ---------- Генератор паролей (Gen Pass, профили 1-3) ----------
# Вид пароля выбирается для каждого профиля в его меню (пункт «Gen»):
#   EN    — случайные символы из CHARS, длина PASSWORD_LENGTH;
#   RU    — случайные русские буквы и цифры, длина PASSWORD_LENGTH;
#   Words — запоминаемый: два слова из words.txt в английской раскладке + 2 цифры
#           и символ из WORDS_SYMBOLS. Например, «Кот Луна 47!» вводится как RjnKeyf47!
PASSWORD_LENGTH = 12
CHARS = "abcdefghijklmnopqrstuvwxyzABCDEFGHIJKLMNOPQRSTUVWXYZ0123456789!@#$%^&*()_+-="
WORDS_SYMBOLS = "!#$%&*?@"

# ---------- Набор пароля ----------
TYPING_DELAY = 0.05        # пауза между символами, сек
TYPING_START_DELAY = 0.4   # пауза после «Ctrl first» (экран блокировки Windows успевает проснуться)

# Переключение раскладки (для паролей с русскими буквами и при Layout: Auto).
# Эти сочетания нужно один раз назначить в Windows:
#   Параметры → Время и язык → Ввод → Дополнительные параметры клавиатуры →
#   Сочетания клавиш для языков ввода: английский — Ctrl+Shift+1, русский — Ctrl+Shift+2
LANG_EN_HOTKEY = (Keycode.LEFT_CONTROL, Keycode.SHIFT, Keycode.ONE)
LANG_RU_HOTKEY = (Keycode.LEFT_CONTROL, Keycode.SHIFT, Keycode.TWO)
LANG_SWITCH_DELAY = 0.3    # пауза после переключения раскладки, сек

# ---------- Кнопки ----------
LONG_PRESS_TIME = 1.0      # сколько держать «Ввод», чтобы открыть меню, сек
NAV_LOCK_HOLD_TIME = 1.0   # сколько держать «Назад»+«Вперёд» для Win+L, сек
NAV_REPEAT_DELAY = 0.5     # держите «Назад» или «Вперёд» дольше — листает само, сек
NAV_REPEAT_INTERVAL = 0.25 # пауза между шагами при таком листании, сек
MEDIA_VOLUME_INTERVAL = 0.1 # пульт MEDIA (SETTINGS -> Media: On): шаг громкости при удержании, сек
BUTTON_DEBOUNCE = 0.03     # защита от дребезга, сек

# ---------- Сон экрана (выбирается в SETTINGS → Sleep / Style) ----------
SLEEP_PRESETS = (15, 30, 60, 120, 300, 0)   # варианты времени, сек. 0 = никогда не засыпать
SLEEP_DEFAULT_PRESET = 1                    # по умолчанию — номер в списке выше, считая с нуля
ANIMATION_FRAME_TIME = 0.05                 # пауза между кадрами анимации, сек
MIX_PERIOD = 120                            # Mix: сколько секунд показывать каждую анимацию

# ---------- Jiggle (выбирается в JIGGLE → Every) ----------
JIGGLE_PRESETS = (30, 60, 120, 300, 600)    # как часто шевелить мышь, сек
JIGGLE_DEFAULT_PRESET = 1                   # по умолчанию — номер в списке выше, с нуля

# ---------- Яркость (выбирается в SETTINGS → Screen / LED) ----------
# Каждый вариант: (название на экране, яркость от 0.0 до 1.0)
SCREEN_BRIGHTNESS = (("Low", 0.05), ("Mid", 0.4), ("High", 1.0))
LED_BRIGHTNESS = (("Off", 0.0), ("Low", 0.2), ("High", 1.0))
BRIGHTNESS_DEFAULT = 2

# ---------- Разное ----------
SPLASH_TIME = 1.0          # заставка при включении, сек (0 — не показывать)
LOG_MAX_SIZE = 16 * 1024   # размер log.txt, после которого он станет log_old.txt, байт

# ---------- Подключение (менять, только если перепаяли на другие контакты) ----------
# Если перепутаны только кнопки на одном устройстве — удобнее hardware_pins.py (см. инструкцию).
PIN_SDA = board.GP4
PIN_SCL = board.GP5
PIN_BACK = board.GP6       # если поменять, поменяйте и в boot.py
PIN_ENTER = board.GP7
PIN_FWD = board.GP8
OLED_ADDRESS = 0x3C
I2C_FREQUENCY = 400000     # скорость связи с экраном. Если на экране помехи — 100000
