hooligan1734-collab/PassPuck/(commit log)

2026-10-15 PassPuck 2.0: hardware password manager on RP2040-Zero
    - CircuitPython 10.2.1 firmware, device files, Cyrillic font, Adafruit libs
    - 6 password profiles, Latin and Cyrillic passwords with automatic
    Windows layout switching, auto-Enter, Ctrl first, Win+L, mouse jiggler
    - Sleep styles, brightness, splash, edit mode from the menu
    - Offline password editor (PassPuck Editor.html) stored on the device
    - Safe password saving with backup, diagnostic log without passwords
    - 3D-printable case, Russian manual (PDF + HTML), hardware_pins example
    [PassPuck_case_rp2040.3mf]
2026-10-15 PassPuck 2.1: precompiled program, settings.py, new sleep animations
    - Program moved to src/passpuck.py and shipped as device/passpuck.mpy
    (built with tools/build.ps1, mpy-cross 10.2.1 with checksum check);
    device/code.py is now a small loader with a clear LED error signal
    - All tunables moved to device/settings.py (kept on updates, defaults
    used for missing values)
    - Cyrillic font loaded on demand only: ~75 KB free RAM instead of ~44 KB
    - New sleep styles: Eyes, Fireworks, Snake, Matrix, Pulse (living ECG
    with beating heart and BPM), Warp, Snow, Lock, and Mix
    - SETTINGS: Preview right after Style, returns to the same line
    - Manual, README and kit updated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
    [code.py, passpuck.py, settings.py]
2026-10-16 PassPuck 2.2: memorable passwords, new screens, one-file install
    - Gen type per profile: EN, RU, Words, Words RU (two 3-4 letter words + digits + symbol; words.txt dictionary, 467 words)
    - Show Pass shows a Russian memory hint for Words; new password is shown right after Gen Pass
    - Main screen: profile number, ENT/CTL/gen badges, large name, position dots, empty-password warning
    - List menus with values, scrollbar and remembered position; hold Back/Fwd to auto-repeat
    - Last used profile remembered across power cycles
    - Layout-neutral characters (digits, ! % * ( ) - _ = +) no longer switch keyboard layout
    - First setup: device opens its drive automatically while no passwords are set
    - tools/m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
    [boot.py, passpuck.py, settings.py]
2026-10-20 PassPuck 2.3: optional media remote
    - New MEDIA screen in the carousel (after profile 6): Enter toggles the remote;
    Enter = play/pause, Fwd/Back = next/previous track, hold = volume up/down,
    hold Enter = exit, Back+Fwd 1 s = Win+L as everywhere
    - The remote survives screen sleep; a press while asleep acts immediately
    - SETTINGS -> Media: On/Off (default Off, MEDIA hidden from carousel and dots)
    - MEDIA_VOLUME_INTERVAL setting; manual section 13 "Пульт для музыки и видео"
2026-10-20 PassPuck 2.4: Snake game
    - New optional GAME screen in the carousel (SETTINGS -> Game: On/Off, default Off),
    between MEDIA and JIGGLE; its menu lists games (Snake with best score)
    - Snake: Speed Easy/Normal/Hard, Walls Solid (solid frame) or Wrap (dotted frame),
    relative turns (Back = left, Fwd = right), Enter = pause, hold Enter = exit,
    speeds up as it grows, best score kept in NVM
    - Carousel skips disabled MEDIA/GAME screens; position dots recentre
    - tools/update-image.ps1: replace changed files inside a previous release image on the PC,
    so a new install image no longer needs a board
    - Manual: section 14 "Игра «Змейка»", sections renumbered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
    [passpuck.py]
